BouzoulasDimitrios/Strain-measuring-device/pictures/IMG_5279.jpg

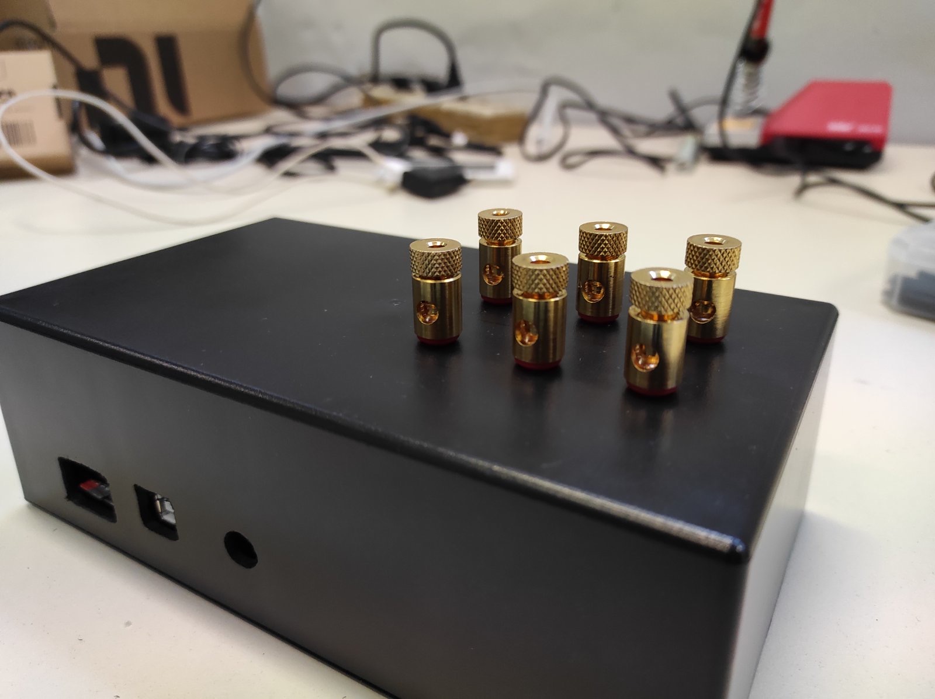
pictures/IMG_5279.jpg
